dietervansteenwegen/FETprobe/README.md

# FETprobe

Electronics design for an active probe.

Based on:

* [Active Probe Bachelor Thesis Hirschbuechler](https://content.instructables.com/ORIG/FQZ/1QZP/IPJTFO82/FQZ1QZPIPJTFO82.pdf), April 2, 2016
* "Poor Man’s 1-GHz probe", Elektuur Magazine, April 2004, article by David Jewsbury, Offline

Schematic and layout in [Diptrace v4](https://wwww.diptrace.com).

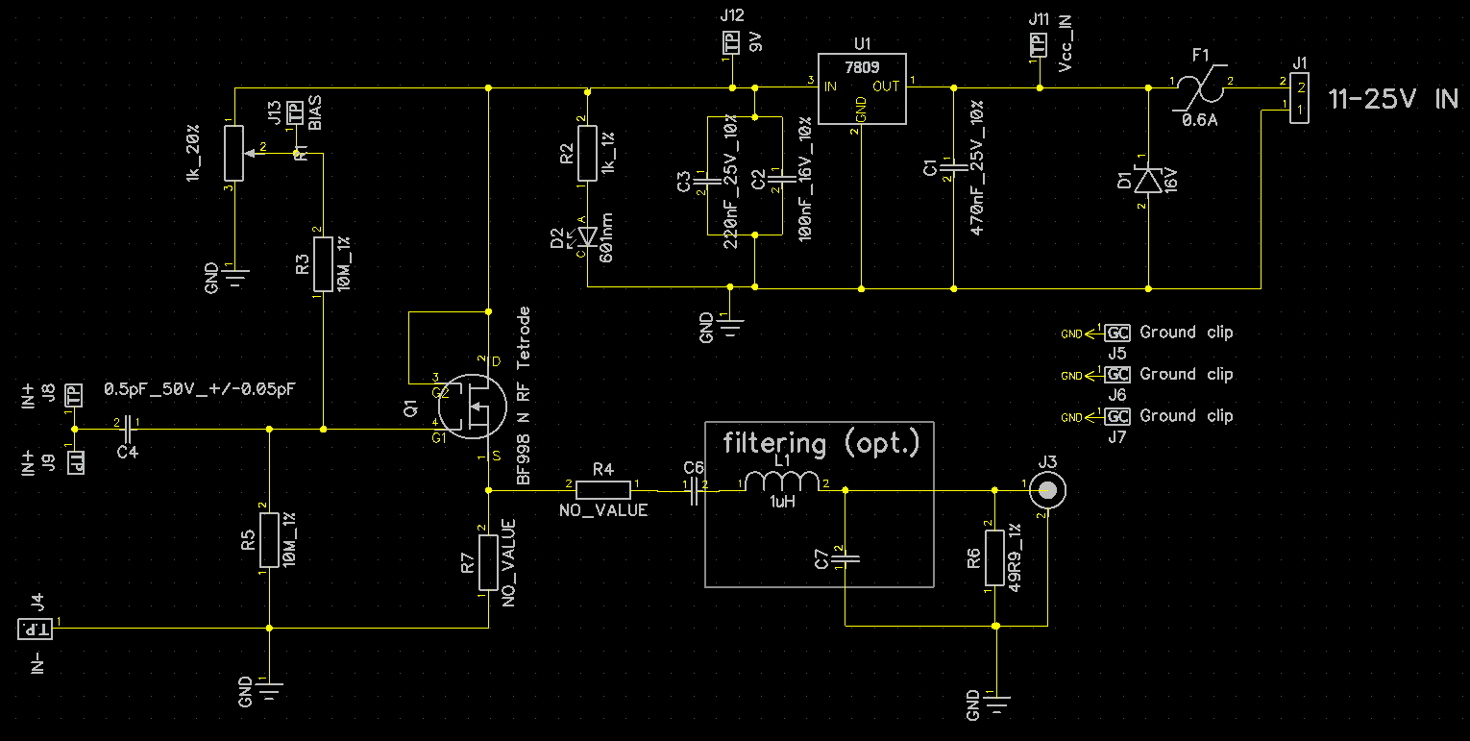
[picture p1: diptrace/v0.1/v0.1_schematic.png]
schematic

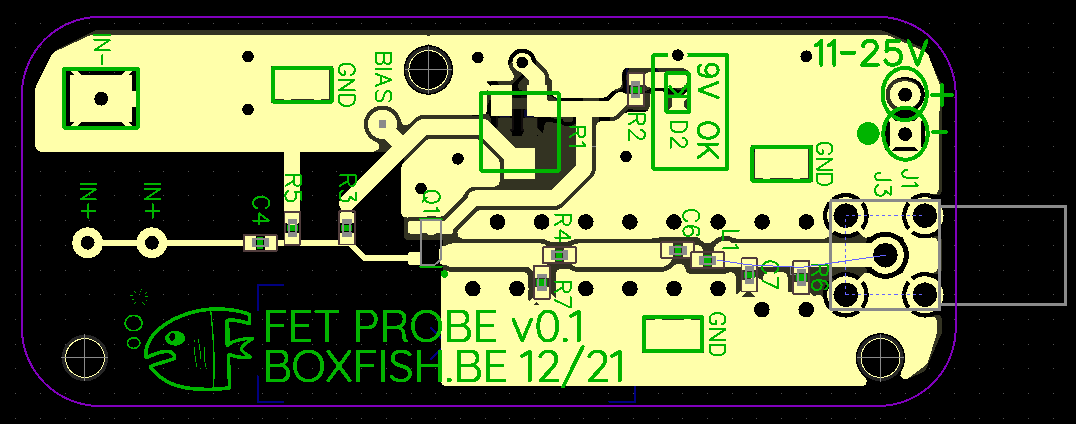
[picture p2: diptrace/v0.1/v0.1_front.png]
front
