dietervansteenwegen/FETprobe/Forum/bode.png

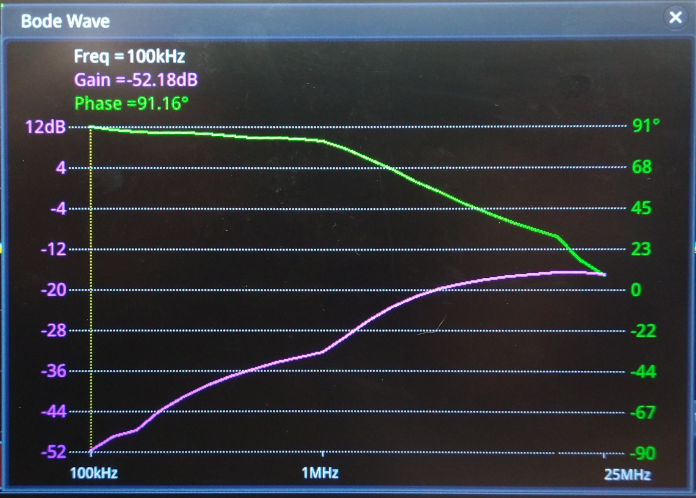
Forum/bode.png
