dietervansteenwegen/FETprobe/Simulation/Input section/Input.png

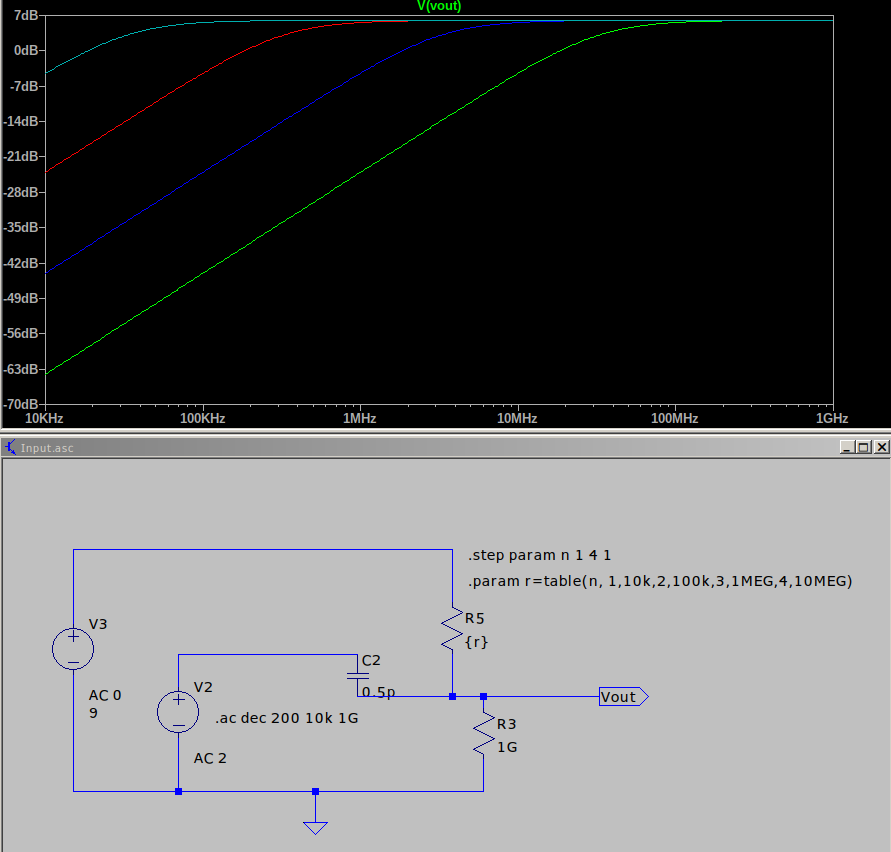
Simulation/Input section/Input.png
