dietervansteenwegen/FETprobe/Simulation/Input section/Input.asc

C2: cap; 0.5p
R3: res; 1G
R5: res; {r}
V2: voltage; ""; AC 2
V3: voltage; 9; AC 0
Named nets: 0, Vout
.param r=table(n, 1,10k,2,100k,3,1MEG,4,10MEG)
.step param n 1 4 1
.ac dec 200 10k 1G
