dietervansteenwegen/FETprobe/(list of files, drawings)

Other design files:
diptrace/v0.1/FETprobe v0.1.dch
diptrace/v0.1/FETprobe v0.1.dip
diptrace/v0.2/FETprobe v0.2.1.dch
diptrace/v0.2/FETprobe v0.2.1.dip
diptrace/v0.2/FETprobe v0.2.dch
diptrace/v0.2/FETprobe v0.2.dip
