dietervansteenwegen/FETprobe/Forum/VNA measurements.txt

Frequency (MHz);S21(Log Mag), dB;S11(Log Mag), dB
    0.300; -33.06;  -0.38
5.298; -20.14;   0.00
10.297; -17.76;  -0.08
15.296; -17.05;  -0.16
20.294; -16.81;  -0.33
25.293; -16.79;  -0.45
30.291; -16.85;  -0.55
35.289; -16.90;  -0.59
40.288; -16.91;  -0.62
45.286; -16.89;  -0.61
50.285; -16.79;  -0.59
55.283; -16.68;  -0.60
60.282; -16.60;  -0.64
65.281; -16.58;  -0.73
70.279; -16.62;  -0.81
75.278; -16.78;  -0.87
80.276; -16.96;  -0.87
85.275; -17.11;  -0.85
90.273; -17.16;  -0.81
95.272; -17.11;  -0.75
100.270; -16.96;  -0.76
105.269; -16.71;  -0.80
110.267; -16.48;  -0.94
115.266; -16.36;  -1.13
120.264; -16.39;  -1.31
125.263; -16.58;  -1.40
130.261; -16.85;  -1.42
135.260; -17.10;  -1.30
140.258; -17.27;  -1.14
145.256; -17.31;  -0.99
150.255; -17.22;  -0.94
155.254; -17.01;  -0.95
160.252; -16.78;  -1.12
165.250; -16.60;  -1.39
170.249; -16.48;  -1.70
175.248; -16.52;  -1.94
180.246; -16.70;  -2.03
185.244; -16.89;  -1.92
190.243; -17.07;  -1.67
195.242; -17.17;  -1.44
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
