dietervansteenwegen/FETprobe/(commit log)

2021-12-01 initial commit of pcb's, need final check
    [FETprobe v0.1.dch, FETprobe v0.1.dip]
2021-12-01 added images of schematic and board
2021-12-01 Added 10M resistor to BOM
    [FETprobe v0.1.dch, FETprobe v0.1.dip]
2021-12-16 v0.2, replaced load resistor to 50R, updated fuse (had wrong farnell number)
    [FETprobe v0.2.dch, FETprobe v0.2.dip]
